Axel-314159/SSTC_2026/README.md

# SSTC 2026

Hardware source files for my 2026 Solid State Tesla Coil design.

## Concept
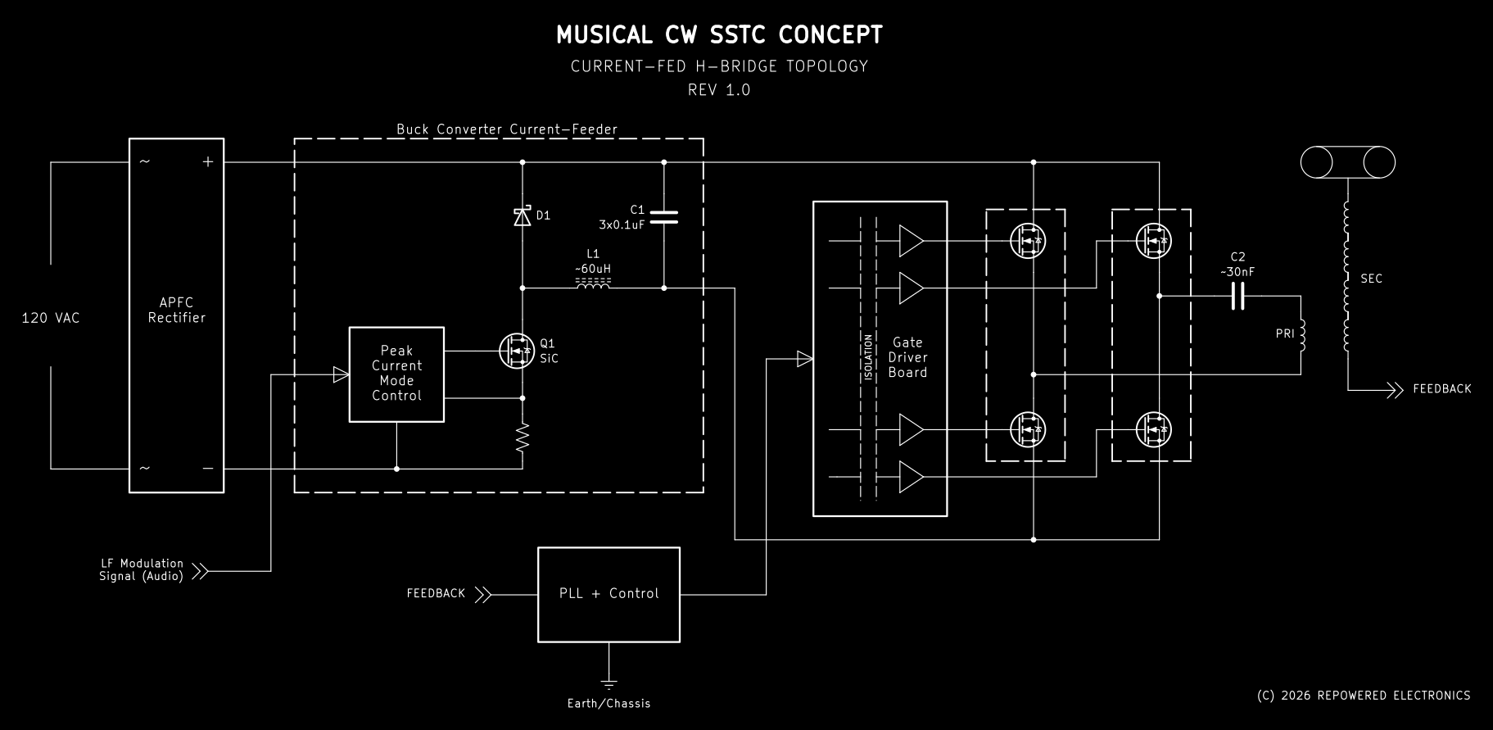
[picture p1: imgs/SSTC_2026_concept_schem.png]
SSTC Concept Diagram
