Axel-314159/SSTC_2026/APFC_2026/README.md

# Active Power Factor Correction (APFC) board

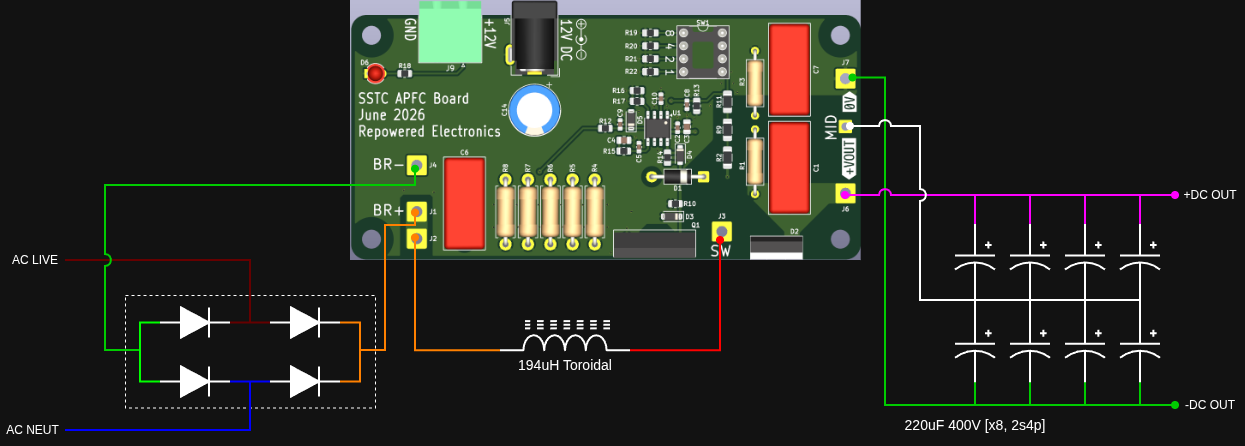
[picture p2: imgs/APFC_diagram.png]
APFC system diagram
