Axel-314159/SSTC_2026/APFC_2026/APFC_2026_SMT.kicad_pcb

## KiCad design APFC_2026/APFC_2026_SMT.kicad_pcb (2026-11-01)

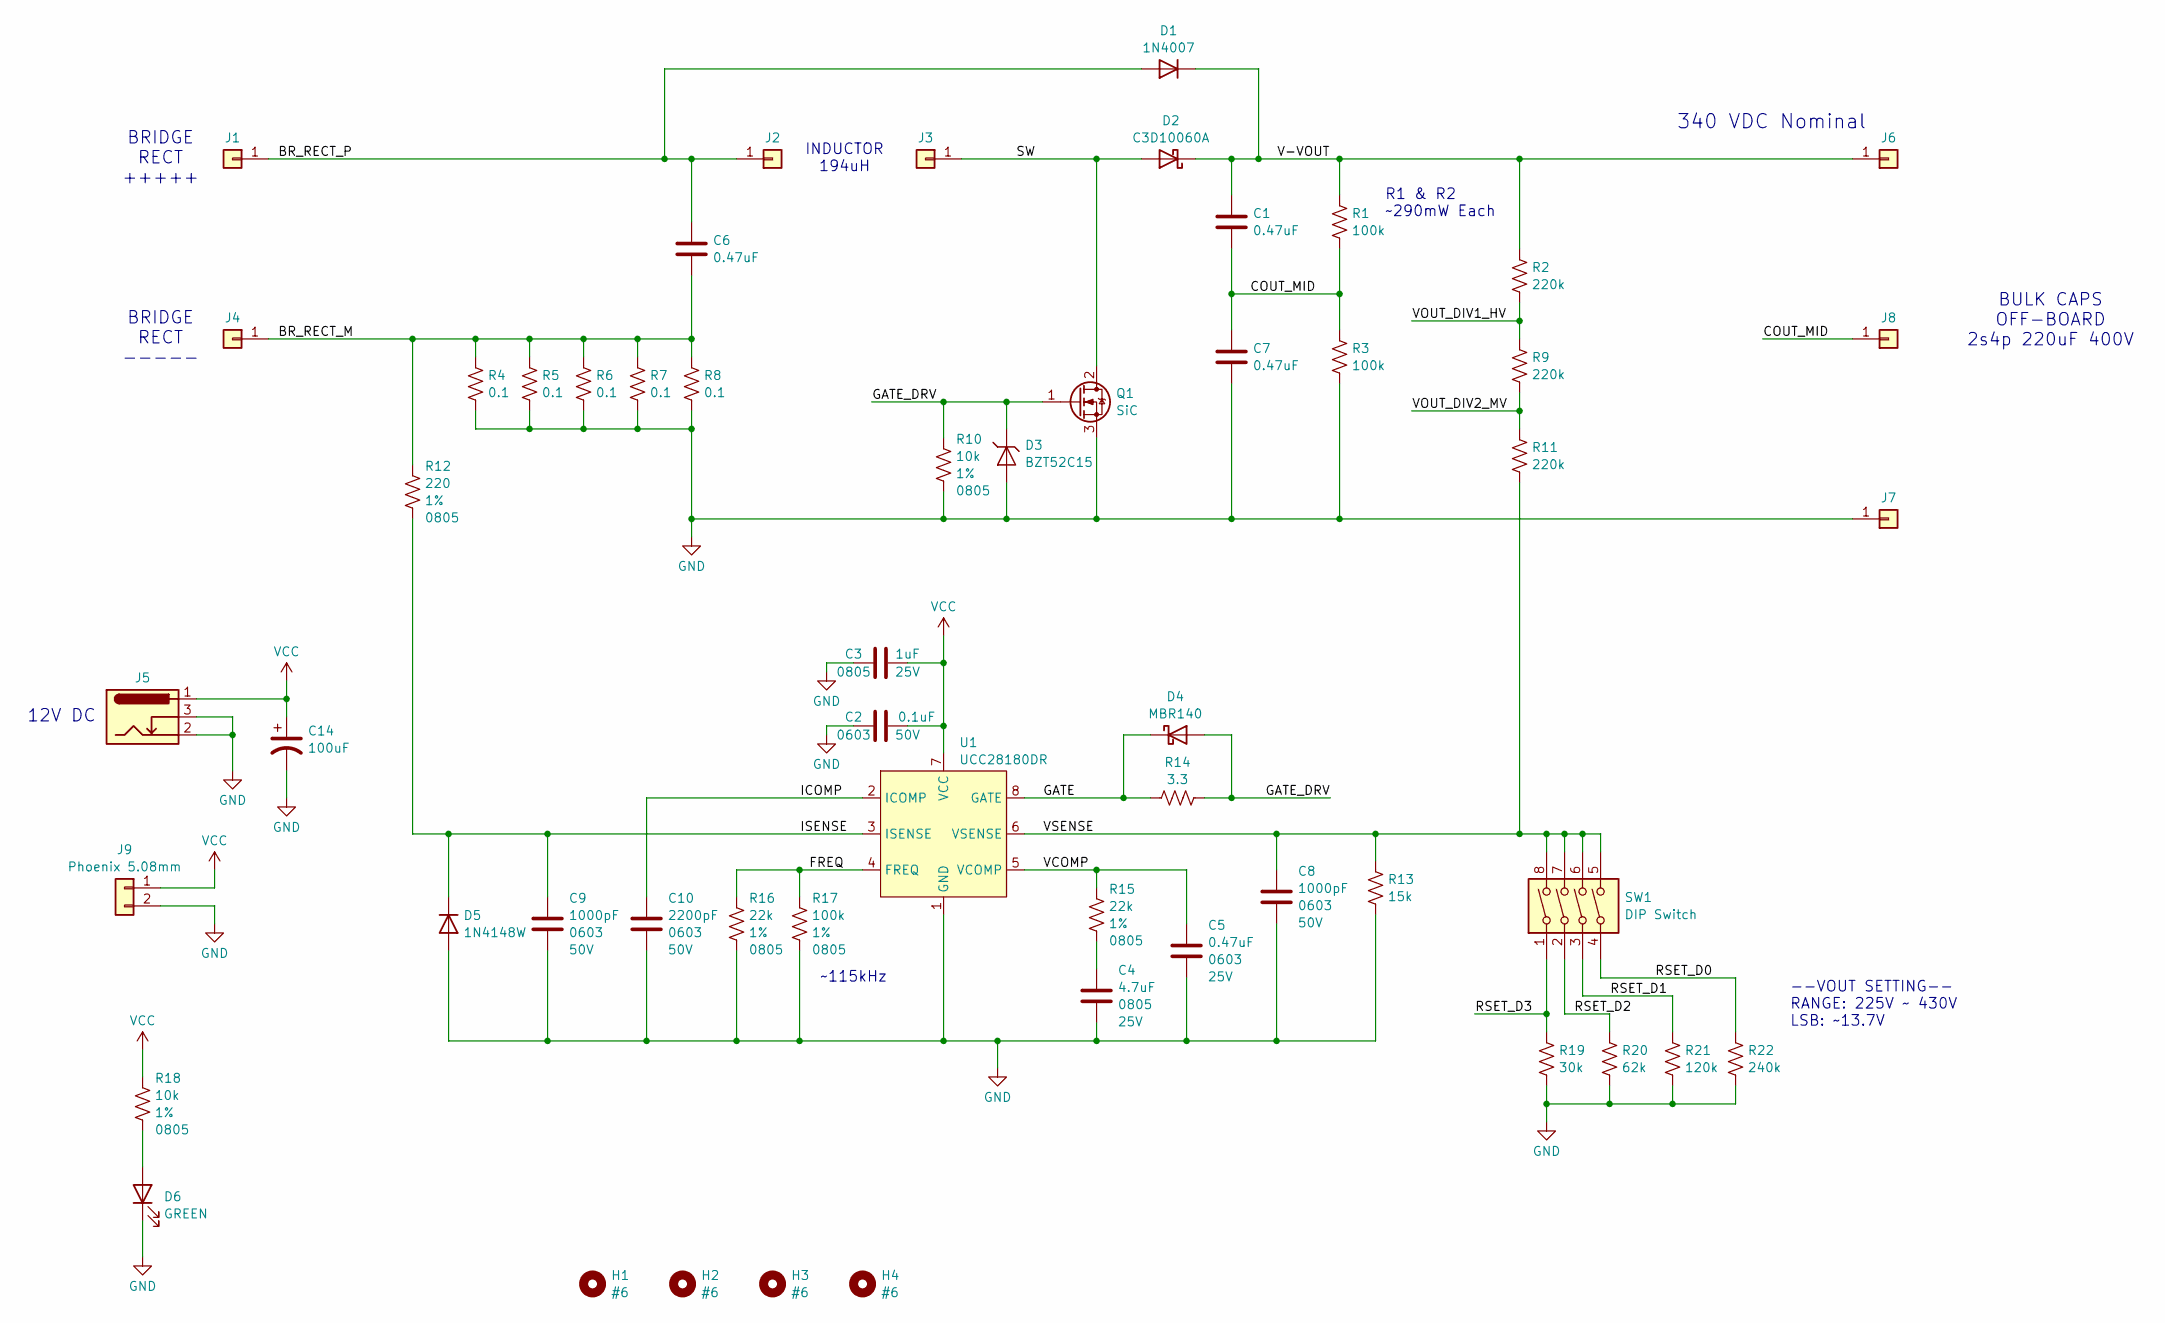
[picture p3: schematic APFC_2026_SMT.kicad_sch]

Parts:
C1, C6, C7: 0.47uF; C_Rect_L18.0mm_W8.0mm_P15.00mm_FKS3_FKP3
C2: 0.1uF; C_0603_1608Metric; Tolerance 5%; Voltage Rating 50V; Mfr Part # CL10B104JB8NNNC; JLCPCB_PN C24452
C3: 1uF; C_0805_2012Metric; Tolerance 10%; Voltage Rating 25V; Mfr Part # CL21B105KAFNNNE; JLCPCB_PN C116352
C4: 4.7uF; C_0805_2012Metric; Tolerance 10%; Voltage Rating 25V; Mfr Part # CL21B475KAFNNNE; JLCPCB_PN C98195
C5: 0.47uF; C_0603_1608Metric; Tolerance 10%; Voltage Rating 25V; Mfr Part # CL10B474KA8NNNC; JLCPCB_PN C1623
C8, C9: 1000pF; C_0603_1608Metric; Tolerance 10%; Voltage Rating 50V; Mfr Part # CL10B102KB8NNNC; JLCPCB_PN C1588
C10: 2200pF; C_0603_1608Metric; Tolerance 5%; Voltage Rating 50V; Mfr Part # CL10C222JB8NNNC; JLCPCB_PN C33353
C14: 100uF; CP_Radial_D10.0mm_P5.00mm
D1: 1N4007; D_DO-41_SOD81_P10.16mm_Horizontal
D2: C3D10060A; TO-220-2_Vertical
D3: BZT52C15; D_SOD-123; MFG_PN BZT52C15; JLCPCB Part # C173427
D4: MBR140; D_SOD-123F; MFG_PN MBR130T3G
D5: 1N4148W; D_SOD-123; MFG_PN 1N4148W; JLCPCB Part # C176288
D6: GREEN; LED_D3.0mm
H1, H2, H3, H4: #6; MountingHole_3.7mm
J1, J2, J3, J4, J6, J7: Conn_01x01; SolderWire-1.5sqmm_1x01_D1.7mm_OD3.9mm
J5: Barrel_Jack_Switch; BarrelJack_Wuerth_6941xx301002
J8: Conn_01x01; SolderWire-0.75sqmm_1x01_D1.25mm_OD2.3mm
J9: Phoenix 5.08mm; PhoenixContact_MSTBA_2,5_2-G-5,08_1x02_P5.08mm_Horizontal
Q1: SiC; TO-247-3_Vertical
R1, R3: 100k; R_Axial_DIN0309_L9.0mm_D3.2mm_P12.70mm_Horizontal
R2, R9, R11: 220k; R_1206_3216Metric_Pad1.30x1.75mm_HandSolder
R4, R5, R6, R7, R8: 0.1; R_Axial_DIN0411_L9.9mm_D3.6mm_P12.70mm_Horizontal
R10, R18: 10k; R_0805_2012Metric; Tolerance 1%; Mfr Part # RC0805FR-0710KL; JLCPCB_PN C84376
R12: 220; R_0805_2012Metric; Tolerance 1%; Mfr Part # RC0805FR-07220RL; JLCPCB_PN C114519
R13: 15k; R_0805_2012Metric_Pad1.20x1.40mm_HandSolder
R14: 3.3; R_0805_2012Metric_Pad1.20x1.40mm_HandSolder
R15, R16: 22k; R_0805_2012Metric; Tolerance 1%; Mfr Part # RC0805FR-0722KL; JLCPCB_PN C114565
R17: 100k; R_0805_2012Metric; Tolerance 1%; Mfr Part # RC0805FR-07100KL; JLCPCB_PN C96346
R19: 30k; R_0805_2012Metric_Pad1.20x1.40mm_HandSolder
R20: 62k; R_0805_2012Metric_Pad1.20x1.40mm_HandSolder
R21: 120k; R_0805_2012Metric_Pad1.20x1.40mm_HandSolder
R22: 240k; R_0805_2012Metric_Pad1.20x1.40mm_HandSolder
SW1: DIP Switch; DIP-8_W7.62mm_Socket
U1: UCC28180DR; SOIC-8_3.9x4.9mm_P1.27mm; MFG_PN UCC28180DR; JLCPCB Part # C88567

Connections:
/BR_RECT_M: C6.2, J4.1, R4.1, R5.1, R6.1, R7.1, R8.1, R12.1
/BR_RECT_P: C6.1, D1.2 (A), J1.1, J2.1
/COUT_MID: C1.2, C7.1, J8.1, R1.2, R3.1
/FREQ: R16.1, R17.1, U1.4 (FREQ)
/GATE: D4.1 (K), R14.1, U1.8 (GATE)
/GATE_DRV: D3.1 (K), D4.2 (A), Q1.1 (G), R10.1, R14.2
/ICOMP: C10.1, U1.2 (ICOMP)
/ISENSE: C9.1, D5.1 (K), R12.2, U1.3 (ISENSE)
/RSET_D0: R22.2, SW1.4
/RSET_D1: R21.2, SW1.3
/RSET_D2: R20.2, SW1.2
/RSET_D3: R19.2, SW1.1
/SW: D2.2 (A), J3.1, Q1.2 (D)
/V-VOUT: C1.1, D1.1 (K), D2.1 (K), J6.1, R1.1, R2.2
/VCOMP: C5.1, R15.1, U1.5 (VCOMP)
/VOUT_DIV1_HV: R2.1, R9.2
/VOUT_DIV2_MV: R9.1, R11.2
/VSENSE: C8.1, R11.1, R13.2, SW1.5, SW1.6, SW1.7, SW1.8, U1.6 (VSENSE)
GND: C2.1, C3.1, C4.2, C5.2, C7.2, C8.2, C9.2, C10.2, C14.2, D3.2 (A), D5.2 (A), D6.1 (K), J5.2, J5.3, J7.1, J9.2, Q1.3 (S), R3.2, R4.2, R5.2, R6.2, R7.2, R8.2, R10.2, R13.1, R16.2, R17.2, R19.1, R20.1, R21.1, R22.1, U1.1 (GND)
unnamed: C4.1, R15.2
unnamed: D6.2 (A), R18.2
VCC: C2.2, C3.2, C14.1, J5.1, J9.1, R18.1, U1.7 (VCC)

Notes on the sheet:
12V DC
R1 & R2 ~290mW Each
BRIDGE RECT +++++
BULK CAPS OFF-BOARD 2s4p 220uF 400V
~115kHz
--VOUT SETTING-- RANGE: 225V ~ 430V LSB: ~13.7V
340 VDC Nominal
BRIDGE RECT -----
INDUCTOR 194uH

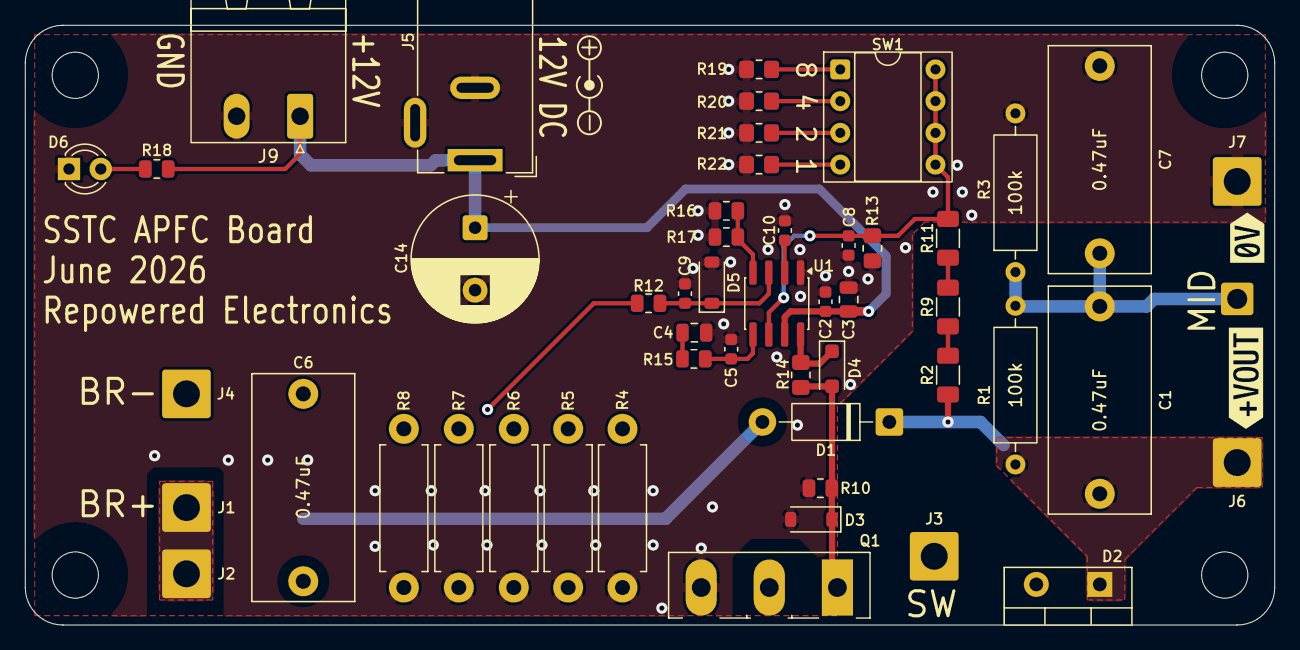
[picture p4: board APFC_2026_SMT.kicad_pcb from above]

Board: 2 copper layers, 100.0 x 48.0 mm, 57 parts (0 on the bottom side), 22 nets.

Other parts of the board:
kibuzzard-6A3E27F1: G***; kibuzzard-6A3E27F1
kibuzzard-6A3624E5: G***; kibuzzard-6A3624E5
